CyberHooves/0000.011F/0000.011F.kicad_pcb

## KiCad design 0000.011F.kicad_pcb (2025-07-11)

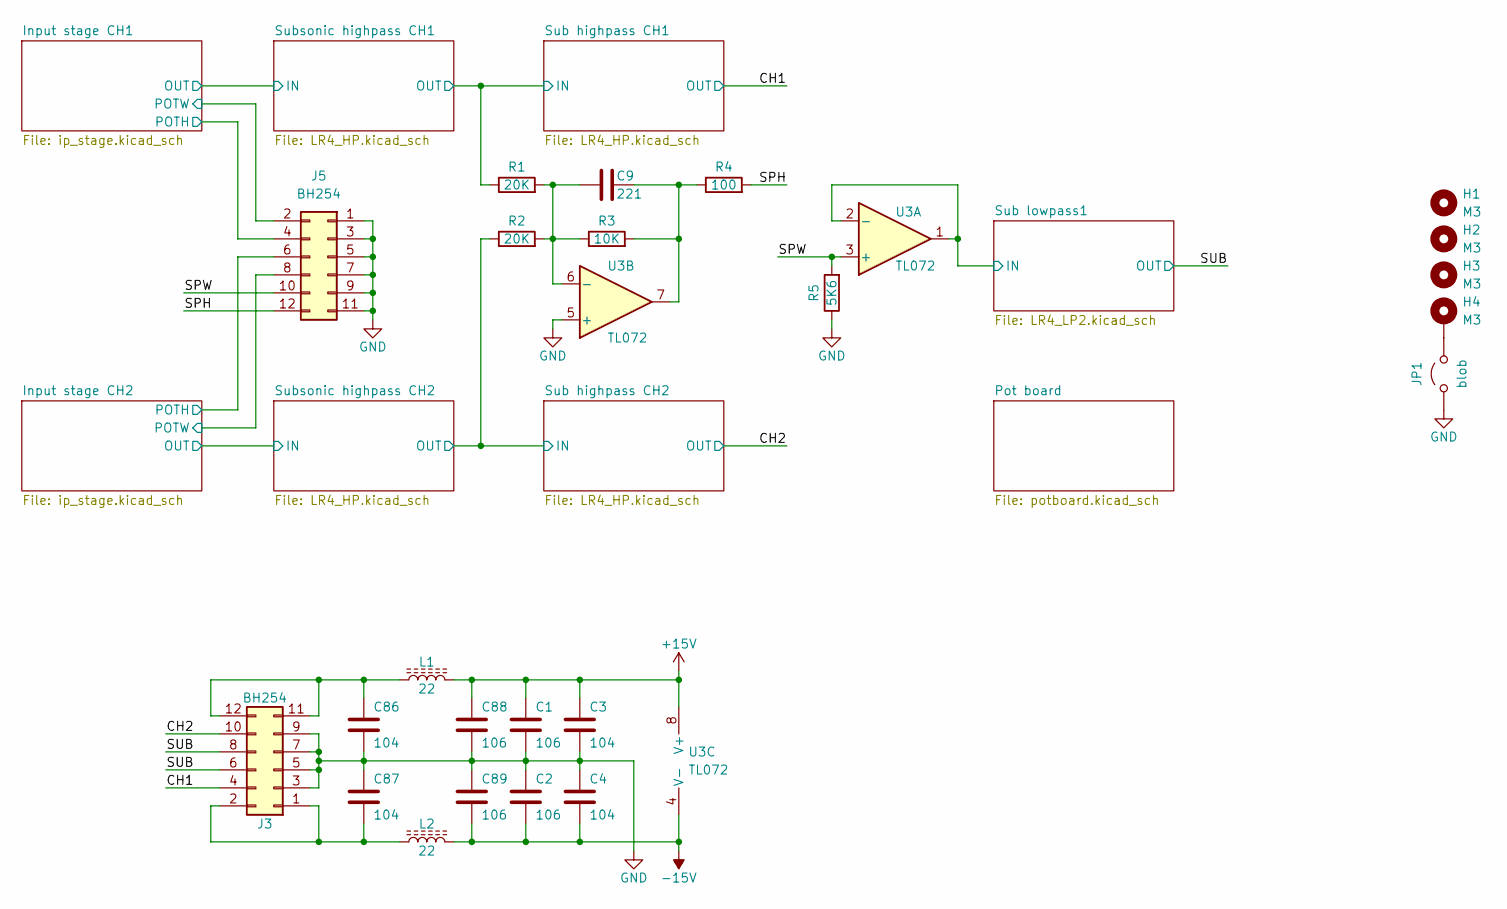
[picture p1: schematic 0000.011F.kicad_sch, Electronic crossover for 2.1 audio systems]

Parts:
C1, C2, C88, C89: 106; C_1210_3225Metric
C3, C4, C86, C87: 104; C_0805_2012Metric
C9: 221; C_0805_2012Metric
H1, H2, H3: M3; MountingHole_3.2mm_M3
H4: M3; MountingHole_3.2mm_M3_Pad
J3, J5: BH254; IDC-Header_2x06_P2.54mm_Vertical
JP1: blob; SolderJumper-2_P1.3mm_Open_RoundedPad1.0x1.5mm
L1, L2: 22; L_1210_3225Metric
R1, R2: 20K; R_0805_2012Metric
R3: 10K; R_0805_2012Metric
R4: 100; R_0805_2012Metric
R5: 5K6; R_0805_2012Metric
U3: TL072; SOIC-8_3.9x4.9mm_P1.27mm

Connections:
+15V: C1.1, C3.1, C88.1, L1.2, U3.8 (V+); also elsewhere on the board
-15V: C2.2, C4.2, C89.2, L2.2, U3.4 (V-); also elsewhere on the board
/CH1: J3.4; also elsewhere on the board
/CH2: J3.10; also elsewhere on the board
/Input stage CH1/POTH: J5.4; also elsewhere on the board
/Input stage CH1/POTW: J5.2; also elsewhere on the board
/Input stage CH2/POTH: J5.6; also elsewhere on the board
/Input stage CH2/POTW: J5.8; also elsewhere on the board
/SPH: J5.12, R4.2
/SPW: J5.10, R5.2, U3.3 (+)
/SUB: J3.6, J3.8; also elsewhere on the board
/Sub highpass CH1/IN: R1.1; also elsewhere on the board
/Sub highpass CH2/IN: R2.1; also elsewhere on the board
/Sub lowpass1/IN: U3.1, U3.2 (-); also elsewhere on the board
GND: C1.2, C2.1, C3.2, C4.1, C86.2, C87.1, C88.2, C89.1, J3.3, J3.5, J3.7, J3.9, J5.1, J5.3, J5.5, J5.7, J5.9, J5.11, JP1.1 (A), R5.1, U3.5 (+); also elsewhere on the board
unnamed: C9.2, R3.2, R4.1, U3.7
unnamed: C87.2, J3.1, J3.2, L2.1
unnamed: C86.1, J3.11, J3.12, L1.1
unnamed: H4.1, JP1.2 (B)
unnamed: C9.1, R1.2, R2.2, R3.1, U3.6 (-)

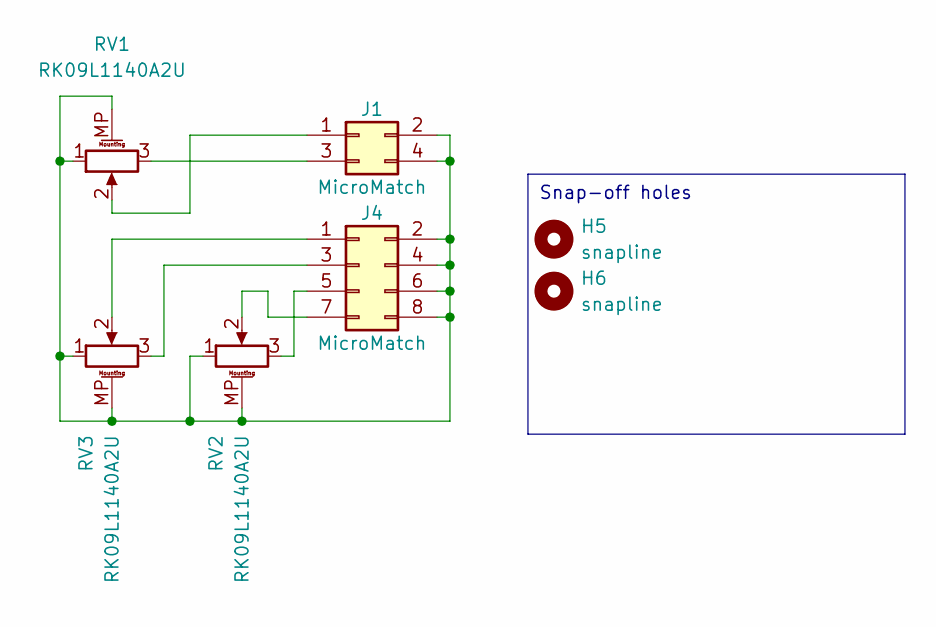
[picture p2: schematic potboard.kicad_sch, Electronic crossover for 2.1 audio systems]

Parts:
H5, H6: snapline; SNAPOFF_5x0.6_P1.2
J1: MicroMatch; TE_Micro-MaTch_215079-4_2x02_P1.27mm_Vertical
J4: MicroMatch; TE_Micro-MaTch_215079-8_2x04_P1.27mm_Vertical
RV1, RV2, RV3: RK09L1140A2U; Potentiometer_Alps_RK09L_Single_Vertical

Connections:
unnamed: J1.1, RV1.2
unnamed: J1.2, J1.4, J4.2, J4.4, J4.6, J4.8, RV1.1, RV1.MP (MountPin), RV2.1, RV2.MP (MountPin), RV3.1, RV3.MP (MountPin)
unnamed: J1.3, RV1.3
unnamed: J4.1, RV3.2
unnamed: J4.3, RV3.3
unnamed: J4.5, RV2.3
unnamed: J4.7, RV2.2

Notes on the sheet:
Snap-off holes

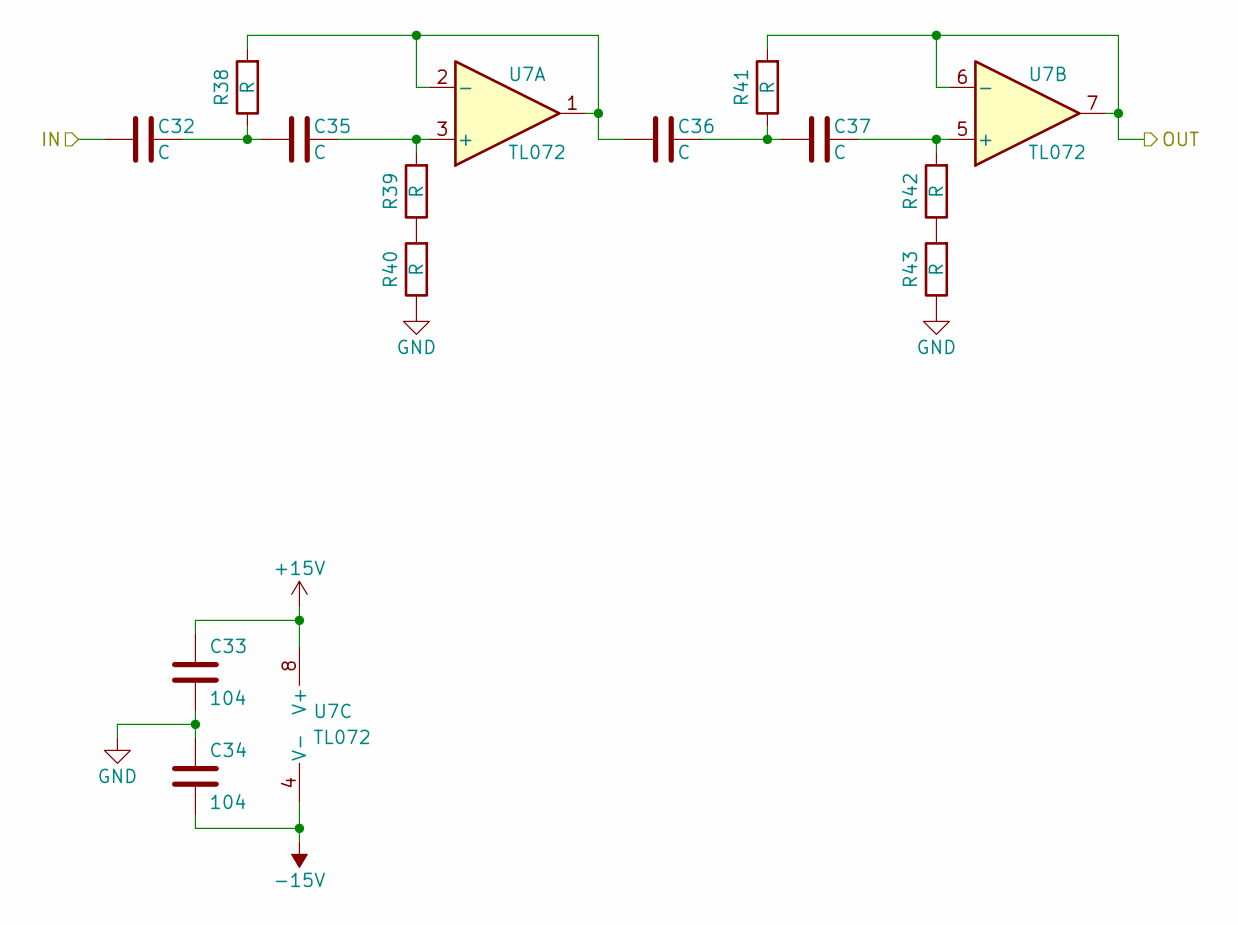
[picture p3: schematic LR4_HP.kicad_sch, Electronic crossover for 2.1 audio systems]

Parts:
C32, C35, C36, C37: C; C_Rect_L7.2mm_W7.2mm_P5.00mm_FKS2_FKP2_MKS2_MKP2
C33, C34: 104; C_0805_2012Metric
R38, R39, R40, R41, R42, R43: R; R_0805_2012Metric
U7: TL072; SOIC-8_3.9x4.9mm_P1.27mm

Connections:
+15V: C33.1, U7.8 (V+); also elsewhere on the board
-15V: C34.2, U7.4 (V-); also elsewhere on the board
/CH1: R41.2, U7.6 (-), U7.7; also elsewhere on the board
/Sub highpass CH1/IN: C32.1; also elsewhere on the board
GND: C33.2, C34.1, R40.1, R43.1; also elsewhere on the board
unnamed: C32.2, C35.1, R38.1
unnamed: C36.2, C37.1, R41.1
unnamed: R39.1, R40.2
unnamed: R42.1, R43.2
unnamed: C35.2, R39.2, U7.3 (+)
unnamed: C36.1, R38.2, U7.1, U7.2 (-)
unnamed: C37.2, R42.2, U7.5 (+)

Parts of its further copies:
C38, C41, C42, C43, C74, C77, C78, C79, C80, C83, C84, C85: C; C_Rect_L7.2mm_W7.2mm_P5.00mm_FKS2_FKP2_MKS2_MKP2
C39, C40, C75, C76, C81, C82: 104; C_0805_2012Metric
R44, R45, R46, R47, R48, R49, R68, R69, R70, R71, R72, R73, R74, R75, R76, R77, R78, R79: R; R_0805_2012Metric
U8, U13, U14: TL072; SOIC-8_3.9x4.9mm_P1.27mm

Connections of its further copies:
+15V: C39.1, C75.1, C81.1, U8.8 (V+), U13.8 (V+), U14.8 (V+); also elsewhere on the board
-15V: C40.2, C76.2, C82.2, U8.4 (V-), U13.4 (V-), U14.4 (V-); also elsewhere on the board
/CH2: R47.2, U8.6 (-), U8.7; also elsewhere on the board
/Input stage CH1/OUT: C74.1; also elsewhere on the board
/Input stage CH2/OUT: C80.1; also elsewhere on the board
/Sub highpass CH1/IN: R71.2, U13.6 (-), U13.7; also elsewhere on the board
/Sub highpass CH2/IN: C38.1, R77.2, U14.6 (-), U14.7; also elsewhere on the board
GND: C39.2, C40.1, C75.2, C76.1, C81.2, C82.1, R46.1, R49.1, R70.1, R73.1, R76.1, R79.1; also elsewhere on the board
unnamed: C38.2, C41.1, R44.1
unnamed: C42.2, C43.1, R47.1
unnamed: C74.2, C77.1, R68.1
unnamed: C78.2, C79.1, R71.1
unnamed: C80.2, C83.1, R74.1
unnamed: C84.2, C85.1, R77.1
unnamed: R45.1, R46.2
unnamed: R48.1, R49.2
unnamed: R69.1, R70.2
unnamed: R72.1, R73.2
unnamed: R75.1, R76.2
unnamed: R78.1, R79.2
unnamed: C41.2, R45.2, U8.3 (+)
unnamed: C42.1, R44.2, U8.1, U8.2 (-)
unnamed: C43.2, R48.2, U8.5 (+)
unnamed: C77.2, R69.2, U13.3 (+)
unnamed: C78.1, R68.2, U13.1, U13.2 (-)
unnamed: C79.2, R72.2, U13.5 (+)
unnamed: C83.2, R75.2, U14.3 (+)
unnamed: C84.1, R74.2, U14.1, U14.2 (-)
unnamed: C85.2, R78.2, U14.5 (+)

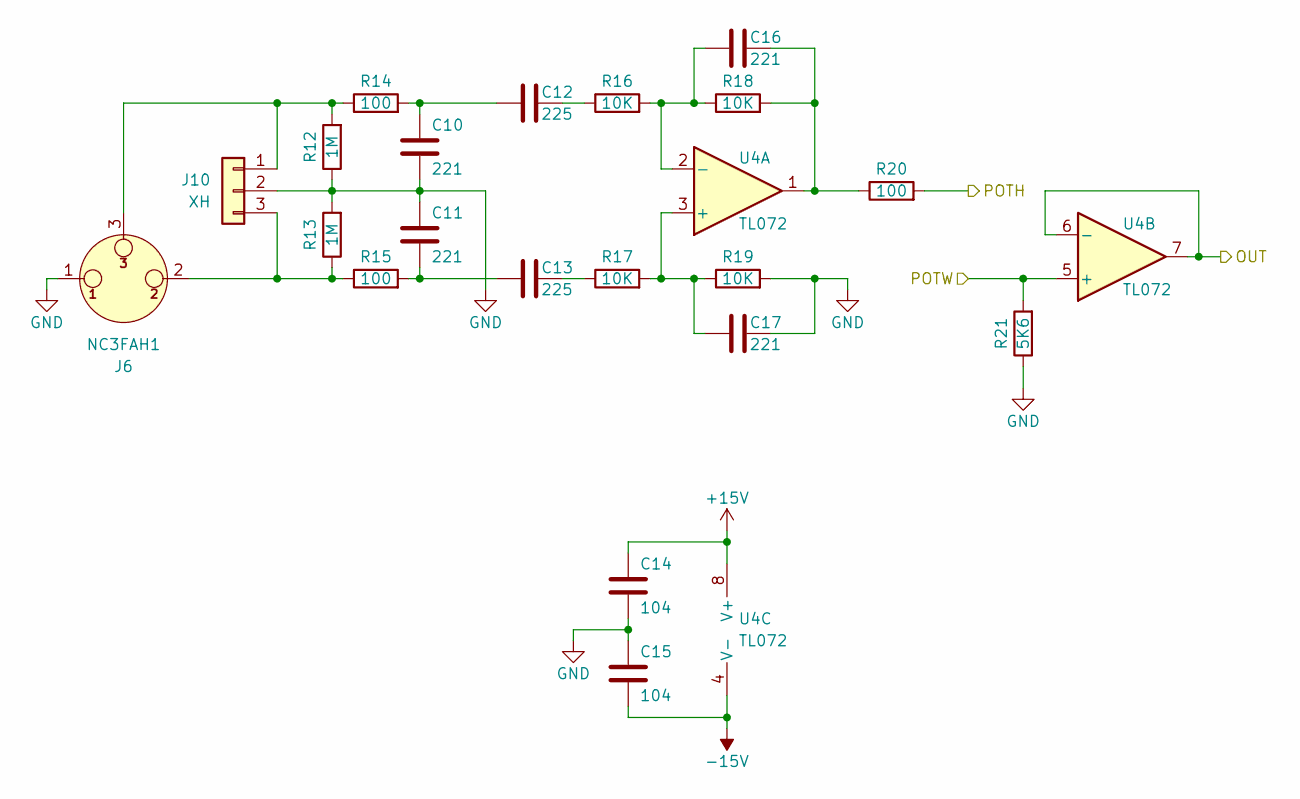
[picture p4: schematic ip_stage.kicad_sch, Electronic crossover for 2.1 audio systems]

Parts:
C10, C11, C16, C17: 221; C_0805_2012Metric
C12, C13: 225; C_Rect_L10.3mm_W5.7mm_P7.50mm_MKS4
C14, C15: 104; C_0805_2012Metric
J6: NC3FAH1; Jack_XLR_Neutrik_NC3FAH1_Horizontal
J10: XH; JST_XH_B3B-XH-AM_1x03_P2.50mm_Vertical
R12, R13: 1M; R_0805_2012Metric
R14, R15, R20: 100; R_0805_2012Metric
R16, R17, R18, R19: 10K; R_0805_2012Metric
R21: 5K6; R_0805_2012Metric
U4: TL072; SOIC-8_3.9x4.9mm_P1.27mm

Connections:
+15V: C14.1, U4.8 (V+); also elsewhere on the board
-15V: C15.2, U4.4 (V-); also elsewhere on the board
/Input stage CH1/OUT: U4.6 (-), U4.7; also elsewhere on the board
/Input stage CH1/POTH: R20.2; also elsewhere on the board
/Input stage CH1/POTW: R21.2, U4.5 (+); also elsewhere on the board
GND: C10.2, C11.1, C14.2, C15.1, C17.2, J6.1, J10.2, R12.1, R13.2, R19.2, R21.1; also elsewhere on the board
unnamed: C10.1, C12.1, R14.2
unnamed: C11.2, C13.1, R15.2
unnamed: C12.2, R16.1
unnamed: C13.2, R17.1
unnamed: C16.2, R18.2, R20.1, U4.1
unnamed: J6.3, J10.1, R12.2, R14.1
unnamed: J6.2, J10.3, R13.1, R15.1
unnamed: C17.1, R17.2, R19.1, U4.3 (+)
unnamed: C16.1, R16.2, R18.1, U4.2 (-)

Parts of its further copies:
C18, C19, C24, C25: 221; C_0805_2012Metric
C20, C21: 225; C_Rect_L10.3mm_W5.7mm_P7.50mm_MKS4
C22, C23: 104; C_0805_2012Metric
J8: NC3FAH1; Jack_XLR_Neutrik_NC3FAH1_Horizontal
J12: XH; JST_XH_B3B-XH-AM_1x03_P2.50mm_Vertical
R22, R23: 1M; R_0805_2012Metric
R24, R25, R30: 100; R_0805_2012Metric
R26, R27, R28, R29: 10K; R_0805_2012Metric
R31: 5K6; R_0805_2012Metric
U5: TL072; SOIC-8_3.9x4.9mm_P1.27mm

Connections of its further copies:
+15V: C22.1, U5.8 (V+); also elsewhere on the board
-15V: C23.2, U5.4 (V-); also elsewhere on the board
/Input stage CH2/OUT: U5.6 (-), U5.7; also elsewhere on the board
/Input stage CH2/POTH: R30.2; also elsewhere on the board
/Input stage CH2/POTW: R31.2, U5.5 (+); also elsewhere on the board
GND: C18.2, C19.1, C22.2, C23.1, C25.2, J8.1, J12.2, R22.1, R23.2, R29.2, R31.1; also elsewhere on the board
unnamed: C18.1, C20.1, R24.2
unnamed: C19.2, C21.1, R25.2
unnamed: C20.2, R26.1
unnamed: C21.2, R27.1
unnamed: C24.2, R28.2, R30.1, U5.1
unnamed: J8.3, J12.1, R22.2, R24.1
unnamed: J8.2, J12.3, R23.1, R25.1
unnamed: C25.1, R27.2, R29.1, U5.3 (+)
unnamed: C24.1, R26.2, R28.1, U5.2 (-)

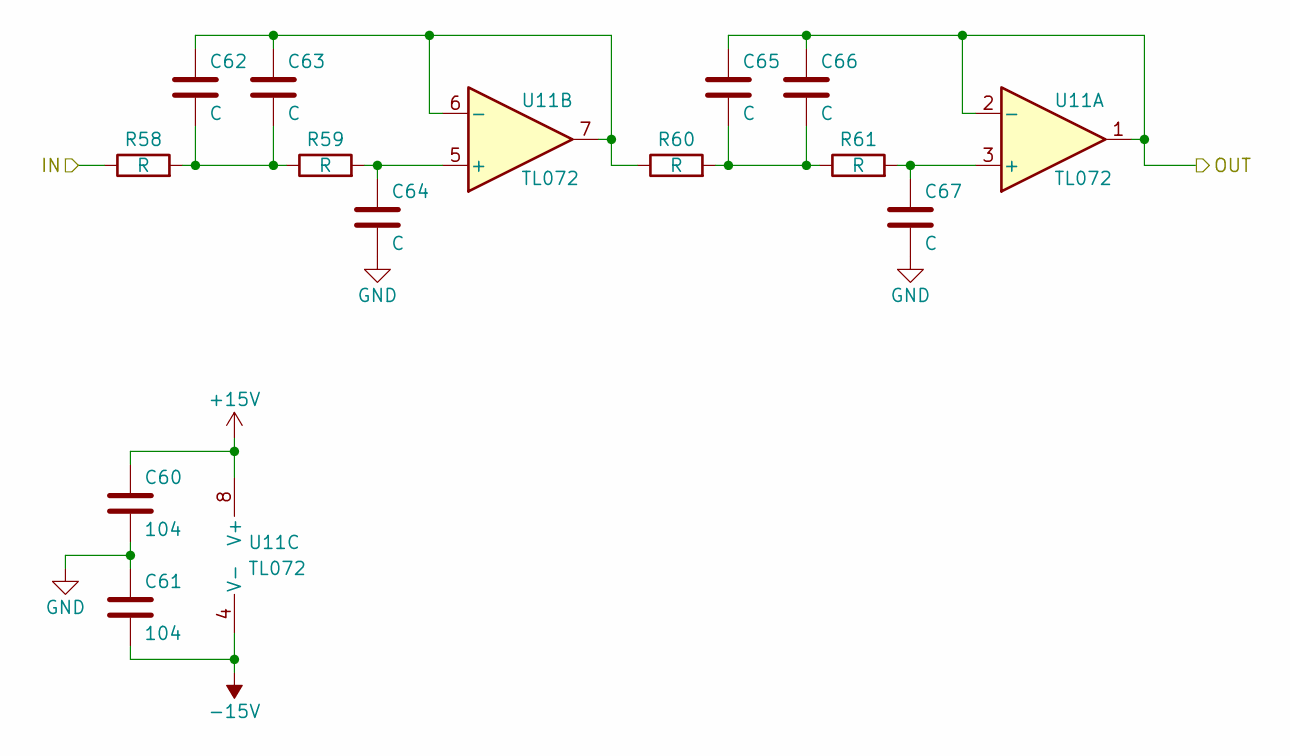
[picture p5: schematic LR4_LP2.kicad_sch, Electronic crossover for 2.1 audio systems]

Parts:
C60, C61: 104; C_0805_2012Metric
C62, C63, C64, C65, C66, C67: C; C_Rect_L7.2mm_W7.2mm_P5.00mm_FKS2_FKP2_MKS2_MKP2
R58, R59, R60, R61: R; R_0805_2012Metric
U11: TL072; SOIC-8_3.9x4.9mm_P1.27mm

Connections:
+15V: C60.1, U11.8 (V+); also elsewhere on the board
-15V: C61.2, U11.4 (V-); also elsewhere on the board
/SUB: C65.1, C66.1, U11.1, U11.2 (-); also elsewhere on the board
/Sub lowpass1/IN: R58.1; also elsewhere on the board
GND: C60.2, C61.1, C64.2, C67.2; also elsewhere on the board
unnamed: C62.2, C63.2, R58.2, R59.1
unnamed: C65.2, C66.2, R60.2, R61.1
unnamed: C67.1, R61.2, U11.3 (+)
unnamed: C64.1, R59.2, U11.5 (+)
unnamed: C62.1, C63.1, R60.1, U11.6 (-), U11.7

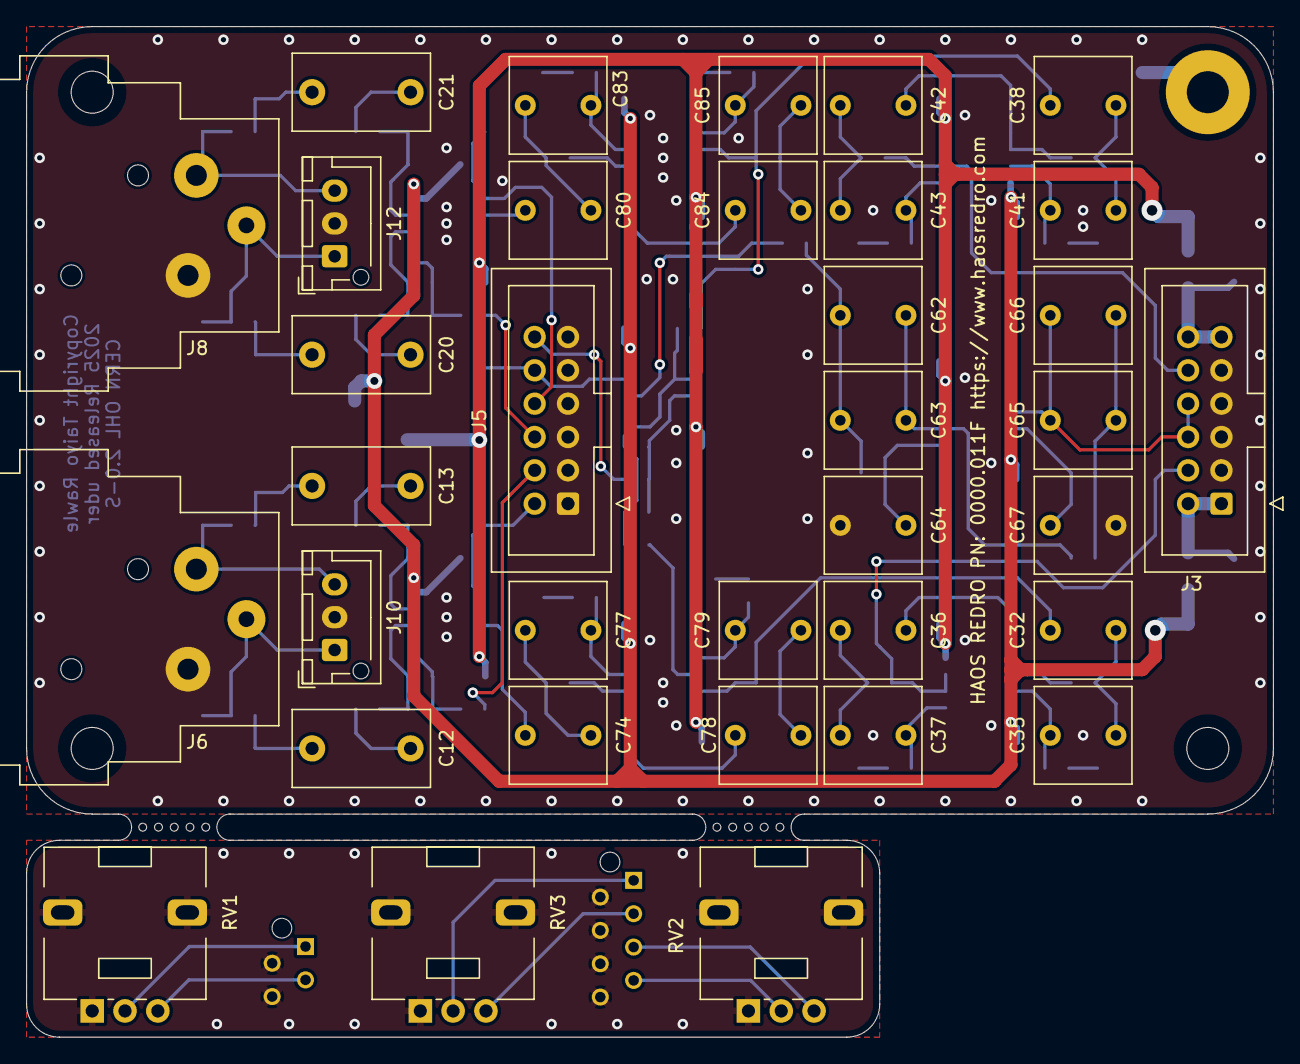
[picture p6: board 0000.011F.kicad_pcb from above]

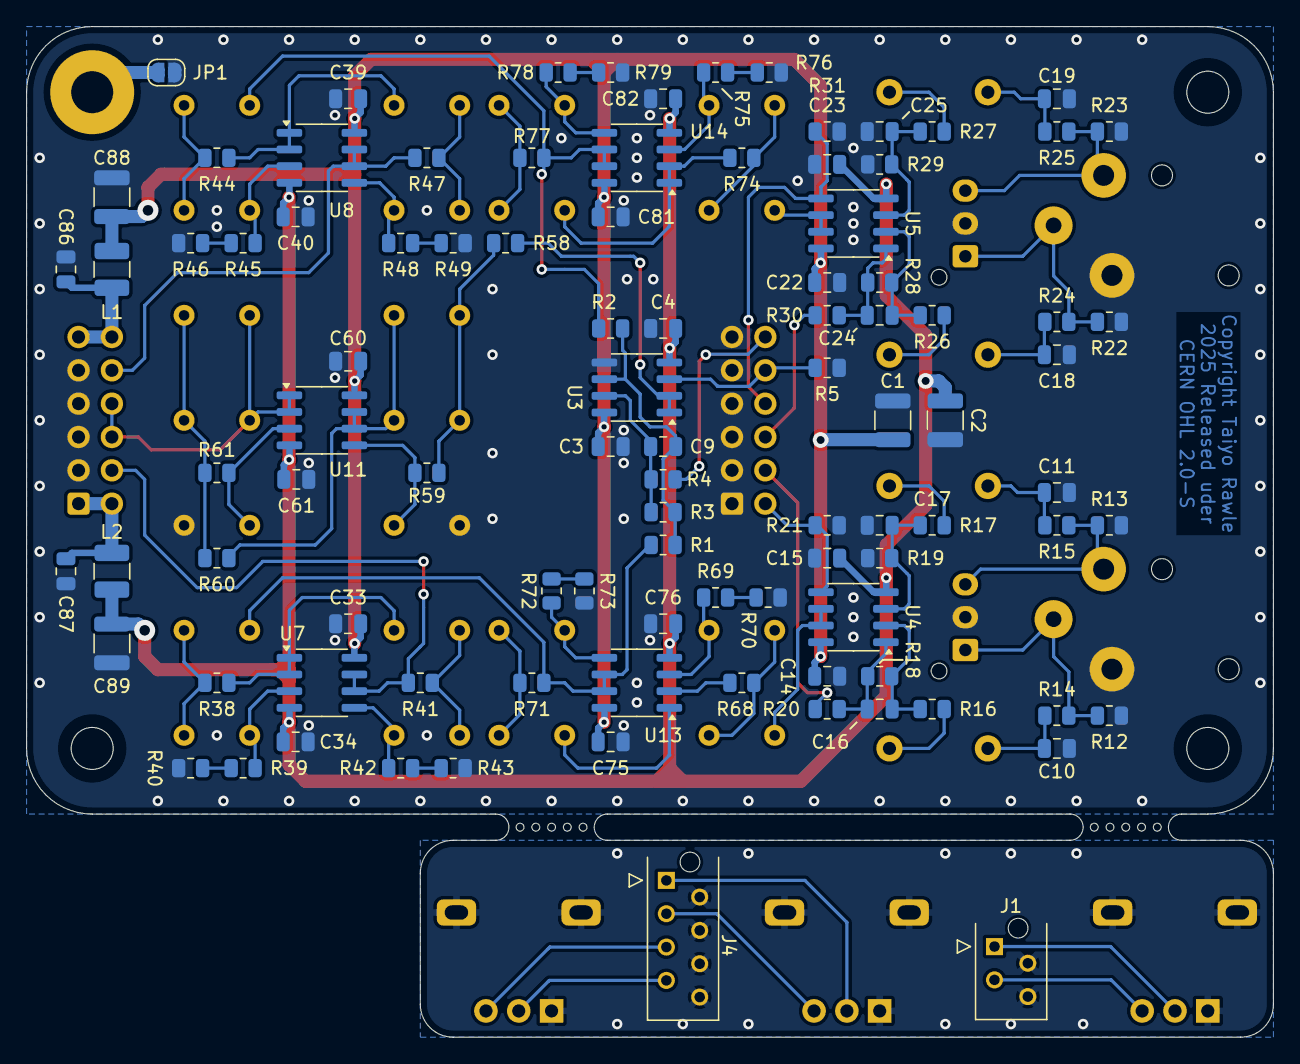
[picture p7: board 0000.011F.kicad_pcb from below]

Board: 2 copper layers, 95.0 x 77.0 mm, 138 parts (97 on the bottom side), 80 nets.
