CyberHooves/0000.011F/(commit log)

2025-07-11 Pot board made smaller using MicroMatch connectors. Snap-off holes tidied up, and gap increased to 2mm for compatibility with some PCB manufacturer's design rules.
    [0000.011F.kicad_pcb, 0000.011F.kicad_sch, potboard.kicad_sch]
2025-07-11 Oops, running DRC would have been sensible. Board outline fixed.
    [0000.011F.kicad_pcb]
