CyberHooves/0000.011F/(notices)

Notices in the files:
0000.011F.kicad_pcb:
Copyright Taiyo Rawle 2025
Released under CERN OHL 2.0-S
CERN OHL 2.0-S
